poshbren/ATTiny_TrueBypassRelay/Production Files/Mouser_BOM.xlsx

TRUE BYPASS RELAY
Mouser # | Mfr. # | Manufacturer | Customer # | Description | RoHS | Lifecycle | Order Qty. | Price (USD) | Ext.: (USD) | Estimated Tariff Price (USD) | Estimated Tariff Ext. (USD)
512-2N7002 | 2N7002 | onsemi |  | MOSFETs N-CHANNEL 60V 115mA | RoHS Compliant |  | 5 | $0.58 | $2.90 | $0.10 | $0.50
653-G6KU-2F-Y-TRDC5 | G6KU-2F-Y-TR DC5 | Omron |  | Low Signal Relays - PCB Gullwing 1Coil 3.2mm DPDT 5VDC 100mW T/R | RoHS Compliant |  | 5 | $4.41 | $22.05 | $0.49 | $2.43
579-ATTINY412-SSF | ATTINY412-SSF | Microchip |  | 8-bit Microcontrollers - MCU 20MHz, 4KB, SOIC8, Ind 125C, Green, Tube | RoHS Compliant |  | 5 | $0.55 | $2.75
621-AP2210N-5.0TRG1 | AP2210N-5.0TRG1 | Diodes Incorporated |  | LDO Voltage Regulators 300mA RF ULDO Reg 0.3A .25V 100uA 68dB | RoHS Compliant |  | 5 | $0.20 | $1.00 | $0.11 | $0.56
306-SM03BSRSSTBLFSNP | SM03B-SRSS-TB(LF)(SN) | JST |  | Headers & Wire Housings SR HEADER (SMT SIDE) | RoHS Compliant | New At Mouser | 5 | $0.76 | $3.80 | $0.27 | $1.37
910-SMD291SNL | SMD291SNL | Chip Quik |  | Solder Solder Paste 15g | RoHS Compliant |  | 1 | $15.29 | $15.29
80-C0805C225K4R3123 | C0805C225K4RAC3123 | KEMET |  | Multilayer Ceramic Capacitors MLCC - SMD/SMT 16V 2.2uF X7R 0805 10% AEC-Q200 | RoHS Compliant |  | 10 | $0.40 | $4.00
80-C0805C104J4JAUTO | C0805C104J4JACAUTO | KEMET |  | Multilayer Ceramic Capacitors MLCC - SMD/SMT 16Vol 0.1uF U2J 0805 5% AEC-Q200 | RoHS Compliant |  | 5 | $1.12 | $5.60
603-RT0805DRD07220RL | RT0805DRD07220RL | YAGEO |  | Thin Film Resistors - SMD | RoHS Compliant By Exemption |  | 10 | $0.132 | $1.32
603-RT0805FRE13100KL | RT0805FRE13100KL | YAGEO |  | Thin Film Resistors - SMD 100K ohm 1% 50 ppm Thin Film | RoHS Compliant By Exemption |  | 5 | $0.10 | $0.50 | $0.02 | $0.10
