poshbren/ATTiny_TrueBypassRelay/Guide.pdf

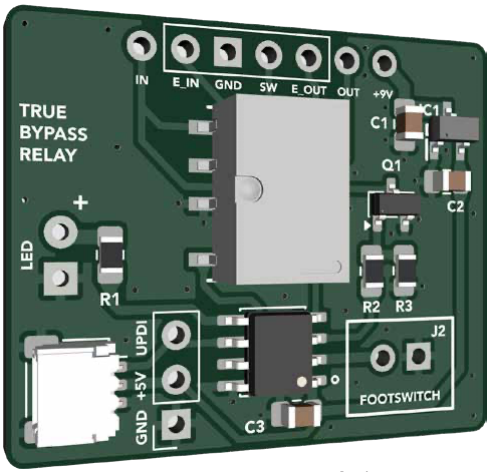
[picture p1: figure]

# COMPONENTS:

# Board Size: 30 x 25mm

See BOM for full component details

# OVERVIEW

## - C1, C2 - 2.2uF

- C3 - 100n

## - LDO (IC1) - AP2210N - Footswitch Connector (J2) - B2B-XH-A-GU (Optional) - UPDI Connector (J4) - SM03B-SRSS-TB_LF__SN_ (Optional) - Relay (K1) - G6KU-2F-Y-TR_DC5 - MOSFET (Q1) - 2N7002 - R1, R2 - 220R

- R3 - 100K

## - MCU (U1) - ATtiny412-SSF - Footswitch - SPST Momentary Normally Open - Optional - 5mm or 3mm LED - Optional - 2.54mm header pins

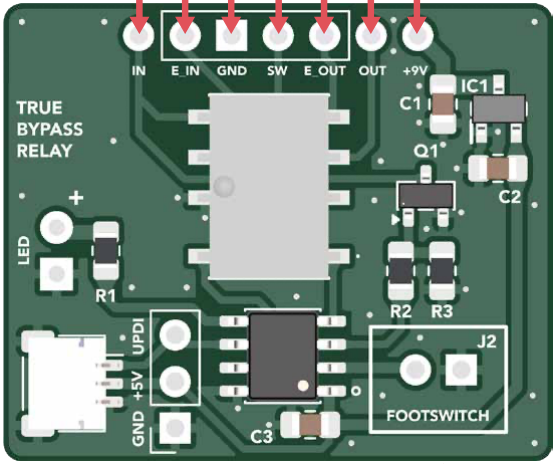
[picture p2: figure]

### UPDI PORT

(for programming)
Plug & Play with Adafruit
UPDI Friend
Install a 2.54mm pin header if not using JST connector

### Signal IN

Wire to input
jack or signal IN

### POWER

Wire to board
power, +9V -
+12V

### LED

(Optional)
Wire in LED, no
external resistor
needed
Change value
of R1 to adjust
brightness

### Effect IN

Wire to effect
input | GND
| Wire to pedal
| ground

### Effect OUT

Wire to effect
output

### Signal OUT

Wire to
output jack or
signal OUT

### LED GND

*Wire to SW on
PedalPCB
board or LED

LED GND *Main PCB must have a resistor between LED and ground. Connecting direct to ground will burn out LED.

### FOOTSWITCH

Plug & Play with LoveMySwitches Pro Footswitch (with JST connector installed) Wire direct to pads if not using connector (Wire order doesn’t matter)
Only use a Normally Open SPST Momentary Foot Switch!

# WIRING DIAGRAM

# SCHEMATIC

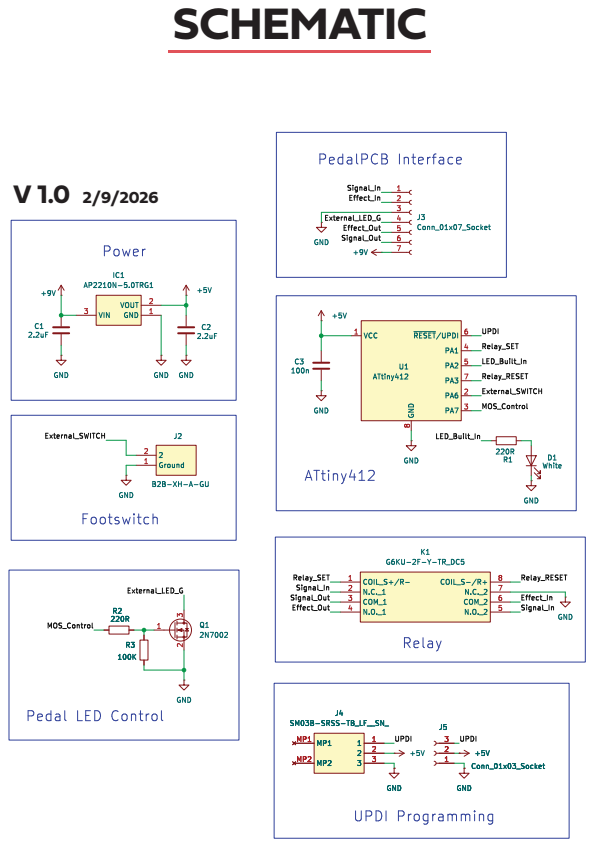
[picture p3: page 3]
