poshbren/ATTiny_TrueBypassRelay/(commit log)

2026-01-24 Refactor pin assignments and LED handling
    Updated pin definitions for switch, relay, and LEDs to improve clarity and flexibility. Refactored LED control logic to support both built-in and external LEDs, added non-blocking blink functionality, and improved code structure for relay pulse and EEPROM operations.
2026-02-01 Update README for clarity on PCB assembly
2026-02-09 Update Pinout to match PCB
    Update pinout to match PCB schematic. Adjust default timings. Add bool value to disable blink effect.
2026-02-09 Add PCB production files
    [JLCPCB_BOM.csv, Mouser_BOM.xls, positions.csv]
2026-02-09 Update Production Files
    Updated files to fix errors when importing to JLCPCB
    [JLCPCB_BOM.csv, positions.csv]
2026-02-10 Add assembly notes to README
2026-02-24 Update production docs
    [JLCPCB_BOM.csv, Mouser_BOM.xls, Mouser_BOM.xlsx, bom.csv, positions.csv]
